XaviCanoFerrer/Educational_Five-Bar_Parallel_Robot/README.md

# Educational_Five-Bar_Parallel_Robot
Designed to play with robotics concepts such as Inverse Kinematics and control algorithms.

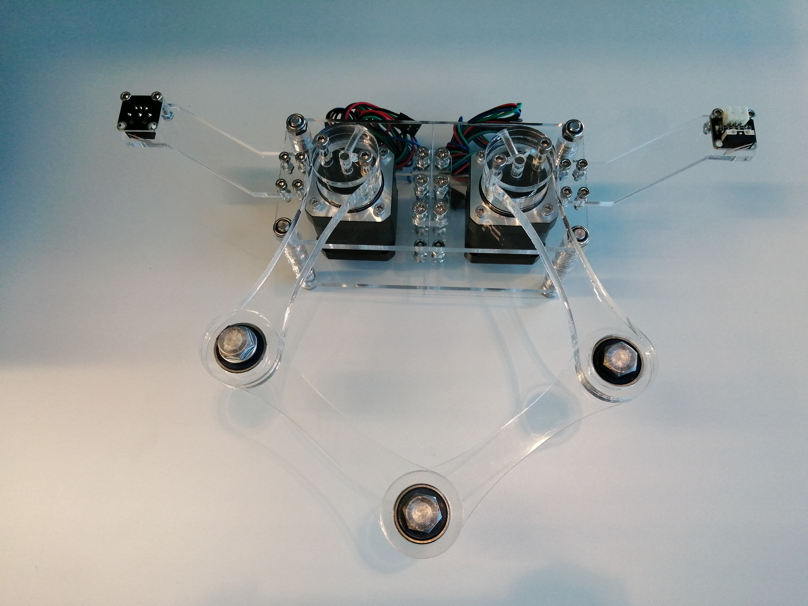
[picture p1: V2.jpg]
