XaviCanoFerrer/Educational_Five-Bar_Parallel_Robot/Educational Five-bar parallel robot_.pdf

# Educational Five-Bar Parallel Robot

Xavier Cano-Ferrer

Abstract- The present paper describes the design of an educational five-bar parallel robot based on the Teensy microcontroller. The small size of the robot and the simplicity of its components makes it suitable for its easy reproduction and programming.

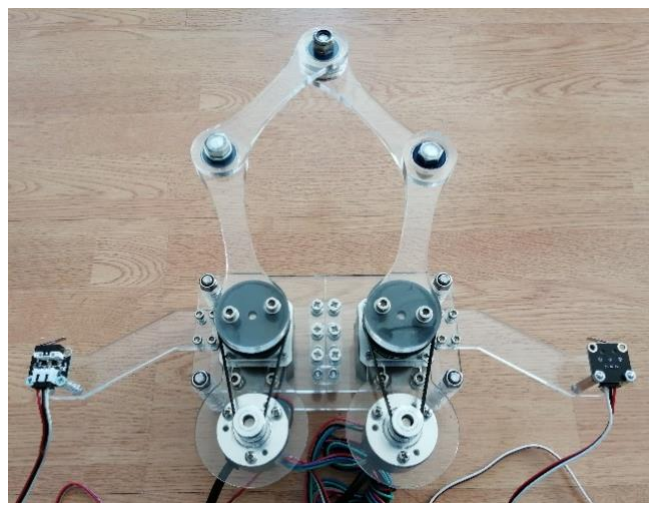
[picture p2: figure]

I. INTRODUCTION

Fiver-bar parallel robots have been studied in academia for years. Some of their most common applications are: drawing [1] [2] or engraving and manipulation [3] [4]. The presented desktop sized five-bar parallel robot (Figure 1) can be fully laser cut, manufactured in one day and programmed using the Arduino IDE and Teensyduino. For these reasons, it can be a good model to learn robotics concepts. The Robot actuators are two stepper motors Nema 17. The motors are driven by two A4988 Stepper Motor Driver Carrier, Black Edition [5]. A Teensy 3.2 microcontroller [6] is the programmable “brain” of the robot. Two limit switches [7] are located on the limits of the workspace of the robot and are used to perform the homing sequence of the robot. A PCB has been designed to operate the robot. All the dxf., step., stl. and Gerber files can be download from the Hackaday project’s page. The project started with a preliminary design based on two Pololu 37D 50:1 geared brushed DC motors sharing their shafts with two rotary incremental encoders. In this first design, the encoders were used to implement a PID position controller for each actuated joint. The control algorithm was programmed on an Arduino Mega 2650 and the motors were driven by the Pololu Dual MC33926 Motor Driver Arduino Shield. On the second design, the brushed DC motors were replaced by stepper motors and the third design is a hybrid of both. The robot is still designed to be operated with the teensyStep library but it has the incremental encoders coupled with the motor shafts to be able to record desired trajectories. All the information of the three designs can be found on the Hackaday project page [8]. In this article the third design will be treated.

II. FORWARD KINEMATICS

The forward kinematic equations have been adapted from Vathan et al. [9]. The equations can be used on the program of the robot to evaluate the position of the end effector of the robot for the given angles q1 and q2 (Figure 2).

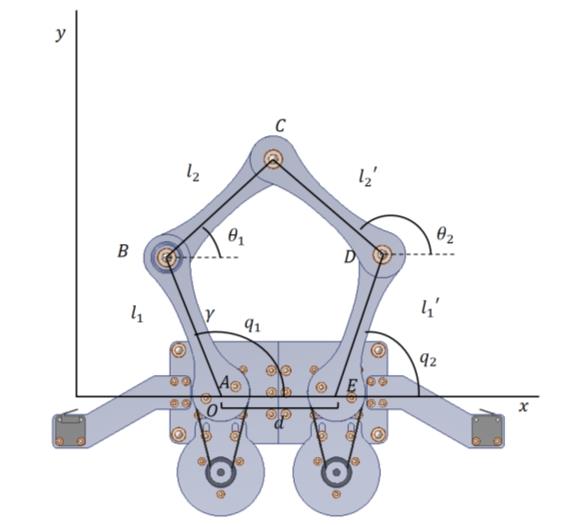
[picture p3: figure]

Figure 2: Forward kinematics diagram of the robot.

Figure 1: Five-bar parallel desktop robot manufactured and asembled.

The position of the end effector can be calculated using the equations:

xC = l1 cos q1 + l2 cos θ1 = d + l1

′
cos q2 + l2

′
cos θ2

yC = l1 sin q1 + l2 sin θ1 = l1

′
sin q2 + l2

′
sin θ2

The joints B and D are not actuated by the stepper motors. For that reason the angles θ1 and θ2 are dependant and q1 and q2 are independent:

θ1 = sin⁻¹ (
l2

′
sin θ2 += l1

′
sin q2 − l1 sin q1
l2

)

θ2 = 2 tan⁻¹ (

A ± √A² + B² − C
2
B − C

)

The value of A, B and C is found using the expressions:

A = 2l2

′
l1

′
sin q2 − 2l1l2

′
cos q1

B = 2l2

′
d − 2l1l2

′
cos q1 + 2l2

′
l1

′
cos q2

C = l1

2 − l2

2 + l1

′2
+ l2

′2
+ d

2
− l1l1

′
sin q1 sin q2
− 2l1d cos q1 + 2l1

′
d cos q2
− 2l1l1

′
cos q1 cos q2

III. INVERSE KINEMATICS

The inverse kinematics equations return the values of the angles q1 and q2 for each value [x,y] of the workspace of the robot (Figure 3). These two equations have been obtained using
geometric | methods. | The | robot | essential
dimensions to calculate the inverse kinematics can be summarized on figure 3. The inverse kinematics have been adapted from the RepRap blog of parallel SCARA 3D printer build [10] and on Shen et al. conference paper [11].

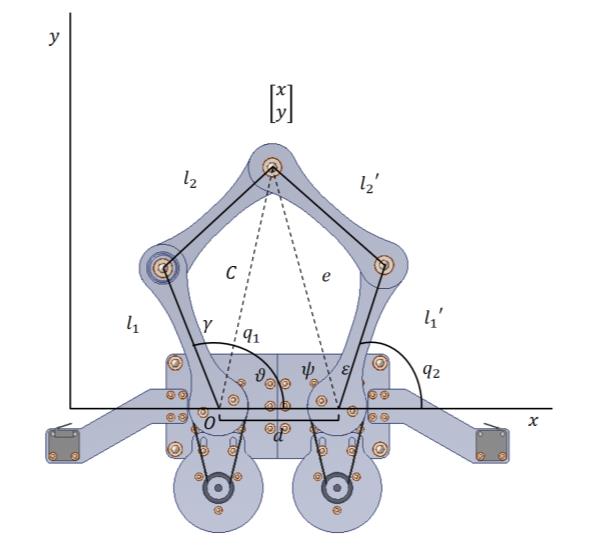
[picture p4: figure]

Figure 3: Inverse kinematics diagram of the robot.

l1 = l2 = l1

′ = l2

′ = 100 mm

d = 80 mm

Left side

C = √x
2 + y

2

θ = tan⁻¹ (

y
x

)

q1 = θ + γ

Applying the cosine rule:

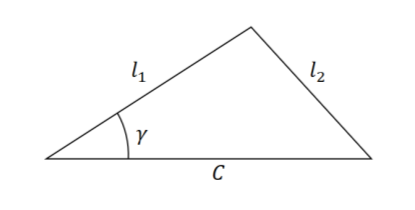
[picture p5: figure]

l2

2 = l1

2 + C
2 − 2l1C cos(γ)

γ = cos⁻¹ (
−l2

2 + l1

2 + C
2
2l1C

)

q1 = tan⁻¹ (

y
x

) + cos⁻¹ (
−l2

2 + l1

2 + C
2
2l1√x
2 + y

2

)

Right side

e = √(d − x)
2 + y

2

ψ = tan⁻¹ (

y
d − x

)

q2 = π − ε − ψ

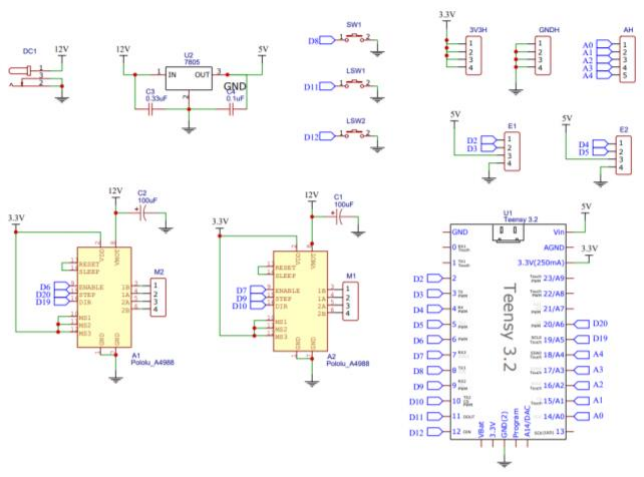
[picture p6: figure]

Applying the cosine rule again:

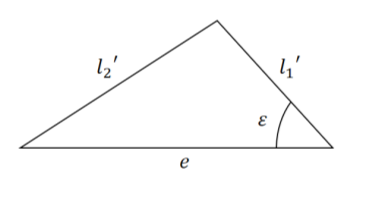
[picture p7: figure]

l2

′2
= l1

′2
+ e

2 − 2l1

′
e cos(ε)

ε = cos⁻¹ (
−l2

′2
+ l1

′2
+ e

2
2l1

′
e

)

q2 = π − tan⁻¹ (

y
d − x

) − cos⁻¹ (
−l2

′2
+ l1

′2
+ e

2

2l1

′√(d − x)
2 + y

2

)

The workspace of the robot can be configured using different modes. This has been studied and implemented on the DexTAR Robot [4] and Tien Dung et al. [12]. These modes are summarized as follows:

- Mode “+-”: q1 = θ + γ and q2 = π − ψ − ε
- Mode “-+”: q1 = θ − γ and q2 = π − ψ + ε
- Mode “--”: q1 = θ − γ and q2 = π − ψ − ε
- Mode “++”: q1 = θ + γ and q2 = π − ψ + ε

The robot program works with mode “+-” by default but this can be changed on the inverse kinematic functions in order to get the desired behaviour.

IV. ELECTRONICS

The two drivers have the three mode pins (M0, M1 and M2) pulled-up (connected to the Teensy 3.3V pin) so the robot works by default with the 3200 steps per revolution resolution. Two 100 µF capacitors are connected to the VMOT pins in order to protect the driver from spikes. The working voltage of the encoders is supplied by a LM7805 voltage regulator (Figure 4). The intention of the third switch is to have an input to tell the robot when you want to use the encoders to record a trajectory to reproduce it afterwards.

V. TIMING BELT DESIGN

The number of teeth zp of the big and the small pulley have been adjusted to get a gear ratio of 3:1 where the number of pulses per revolution of the encoder is increased in a factor of three. In the case of the selected encoders, from 600 pulses/revolution to 1800 pulses per revolution. Due to the dimensions of the robot, the adequate size of the timing belt is the GT2. Therefore, the pitch is 2.032 mm.

dp =

p zp
π

Once the big and small pulley diameters defined (D and d) the distance between both C has been calculated in order to get the desired commercial length L:

L = 2C +

π
2

(D + d) +

(D − d)

2
4C

The length obtained is 192.95 mm and a commercial and suitable option is the: RS PRO, Timing Belt, 95 Teeth, 193.04 mm length and 6mm Width [13]. The encoders can be added as an additional feature because the encoder holder can be attached to the motor holder using two M4 screws. The belt tension can be adjusted by translating the encoder holder before tightening the screws.

Figure 4: Proposed schematic of the Robot including the two stepper motors, two limit switches, Pololu A4988, two encoder connections, one switch and the Teensy 3.2.

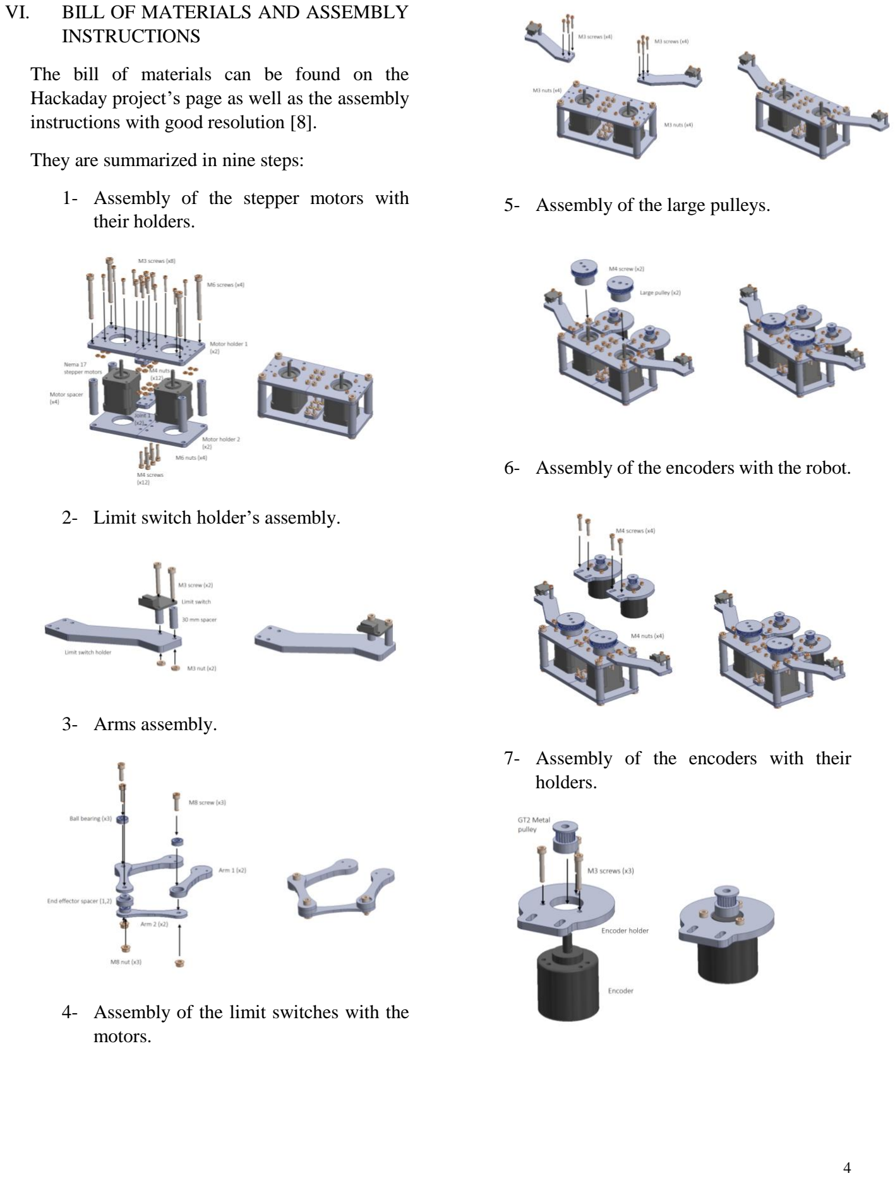
[picture p8: page 4]

VI. | BILL OF MATERIALS AND ASSEMBLY INSTRUCTIONS
| The bill of materials can be found on the Hackaday project’s page as well as the assembly instructions with good resolution [8].
| They are summarized in nine steps:
| 1- Assembly of the stepper motors with their holders.

2- Limit switch holder’s assembly.

3- Arms assembly.

4- Assembly of the limit switches with the motors.

5- Assembly of the large pulleys.

6- Assembly of the encoders with the robot.

7- Assembly of the encoders with their holders.

8- Timing belts assembly.

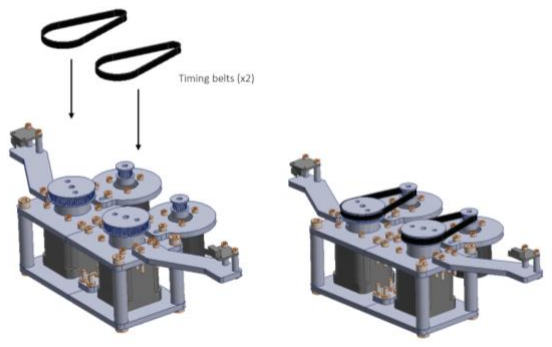
[picture p9: figure]

9- Assembly of the arms with the rest of the robot.

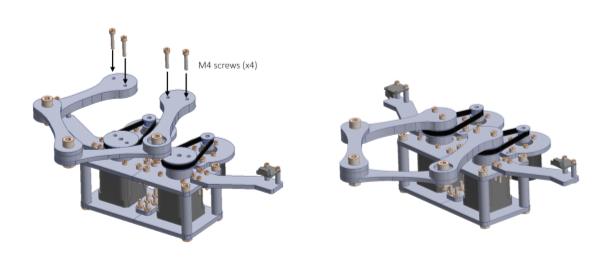
[picture p10: figure]

VI. BASIC PROGRAM

The robot is intended to use the TeensyStep library [14]. Which is perfect to manage several motors making a synchronous movement and also work with a huge range of speeds and accelerations (up to 300,000 steps/s and 500,000 steps/s^2) to get precise and fast movements to the robot. The homing procedure starts moving both arms to the right side until the right arm reaches the right end switch. Then the robot starts rotating both arms counter clock wise and counting the number of steps that the right arm is doing. When the left arm reaches the left end switch, both motors stop, the number of steps is converted to an angle and the left arm angle is set to 180 degrees. After the homing procedure, the end effector is moved on the position [40,170] and from that position is called to draw a small rectangle. A basic program of the robot drawing a square can be seen on YouTube [15].

VII. RESULTS

The Parallel robot has been designed to use the 3200 steps per revolution configuration. With this configuration, the theoretical resolution is 0.1125 degrees per step. The repeatability test has been measured in the x and y axes (N = 18, ω = 56.25 ° ∙ s

−1
and α = 112.5 ° ∙ s

−2
) using a
KATSU | Dial | Test | Indicator | [16]. | The
repeatability (RP) has been calculated using the equations proposed by Barrientos et al. where Lm and Ls are the average and the standard deviation of all the distances reached from the barycentre (Lj) [17]:

Lj = √(xj − xm)
| | | 2 + (yj − ym) | 2

Lm =

∑ Lj
n − 1

Ls = √
∑(Lj − Lm)
n − 1

RP = Lm + 3Ls

The repeatability (RP) obtained with the experimental results has been 0.1147 mm. This value corresponds to the cyan circle diameter (Figure 6).

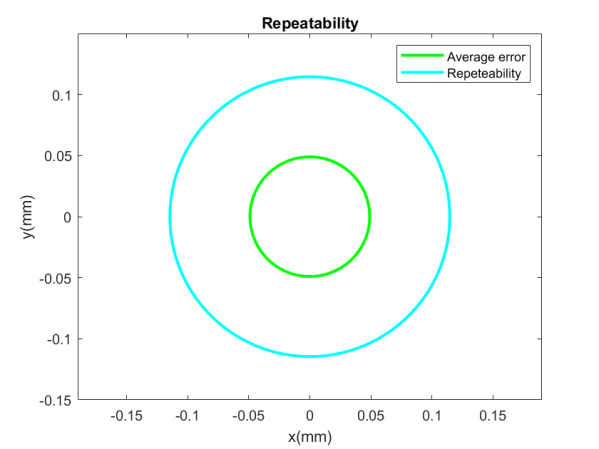
[picture p11: figure]

Figure 6: Repeatability and average error plot.

The repeatability test for the y axis can be seen on the YouTube channel [18].

VIII. DISCUSSION

This robot can be easily manufactured and assembled in a few hours. All the components are accessible and inexpensive.

The basic robot tools can be subject of study with this robot are: forward and inverse kinematics, homing sequence, stepper motor speed and acceleration profiles, closed loop position control algorithms (P, PI, PD, PID) and trajectory recording. For all this reasons this tool can be suitable to use in educational workshops for adults or practical lessons in engineering schools.

REFERENCES

[1] “https://www.thingiverse.com/thing:2480 09,” [Online].
[2] F. Cemal and I. Katip, “Real time controlled two dof five bar robot manipulator,” in Proceedings of the International Symposium of Mechanism and Machine Science, Baku, 2017.
[3] N. Siltala, A. Vuola, R. Heikkilä and R. Tuokko, “A H-scara mini robot - a dual parallel kinematics mini manipulator,” in Proceedings of the joint conference of the 41st International Symposium on Robotics, Munich, 2010.
[4] L. Campos, F. Bourbonnais, I. A. Bonev and P. Bigras , “DEVELOPMENT OF A FIVE-BAR PARALLEL ROBOT WITH LARGE WORKSPACE,” in Proceedings of the ASME 2010 International Design Engineering Technical Conferences & Computers and Information in Engineering Conference, Montreal, 2010.
[5] “https://www.pololu.com/product/2128,” [Online].
[6] “https://www.pjrc.com/store/teensy32.ht ml,” [Online].
[7] “https://www.amazon.co.uk/gp/product/B07F342J8K/ref=ppx_yo_dt_b_asin_title_o03_s00?ie=UTF8&psc=1,” [Online].
[8] “https://hackaday.io/project/173325-educational-five-bar-parallel-robot-double-scara,” [Online].
[9] L. Vathan.B, H. Kumar and B. . I. John. H, “Kinematic Analysis of Five-Bar Mechanism in Industrial Robotics”.
[10] “https://reprap.org/forum/read.php?185,4 90216,,” [Online].
[11] S. Yanli, L. Yanli, W. Hongtao, H. Chunlong and W. Shuai , “Forward and Inverse Kinematics for a Novel Double Scara Robot,” in 2nd International Symposium on Resource Exploration and Environmental Science, 2018.
[12] L. Tien Dung, K. Hee-Jun and D. Quang Vinh , “A Method for Optimal Kinematic Design of Five-bar Planar Parallel Manipulators,” 2017.
[13] “https://uk.rs-online.com/web/p/timing-belts/7785054/,” [Online].
[14] “https://luni64.github.io/TeensyStep/,” [Online].
[15] “https://www.youtube.com/watch?v=c6j G3WN4W8Y,” [Online].
[16] “https://www.amazon.co.uk/KATSU-Indicator-0-10mm-Magnetic-Storage/dp/B088FX6P91,” [Online].
[17] A. Barrientos, L. F. Peñin, C. Balaguer and R. Aracil Santoja, Fundamentos de Robótica, Madrid: McGraw-Hill, 2007.
[18] “https://www.youtube.com/watch?v=BfiHG13mHDs&feature=youtu.be,” [Online].
