XaviCanoFerrer/Educational_Five-Bar_Parallel_Robot/V1 and V2.jpg

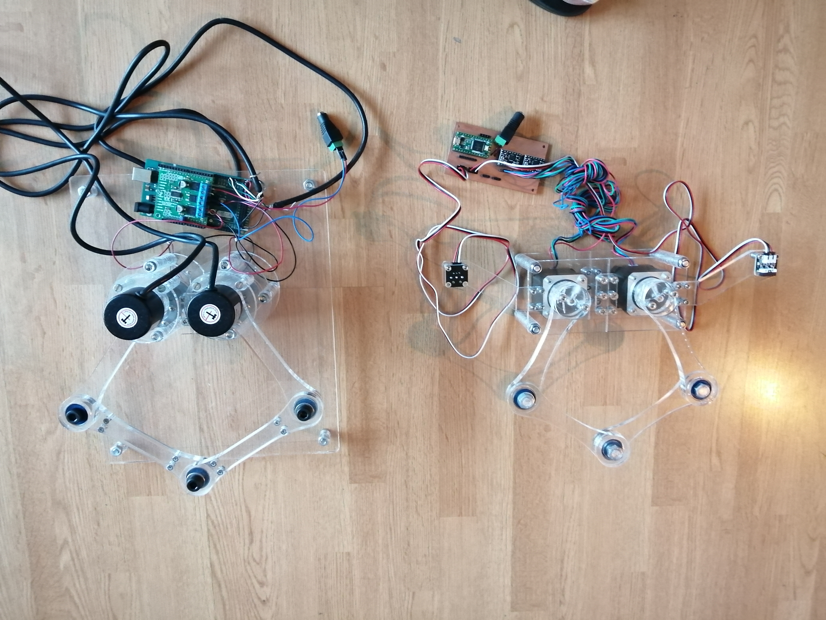
V1 and V2.jpg
