XaviCanoFerrer/Educational_Five-Bar_Parallel_Robot/V3.jpg

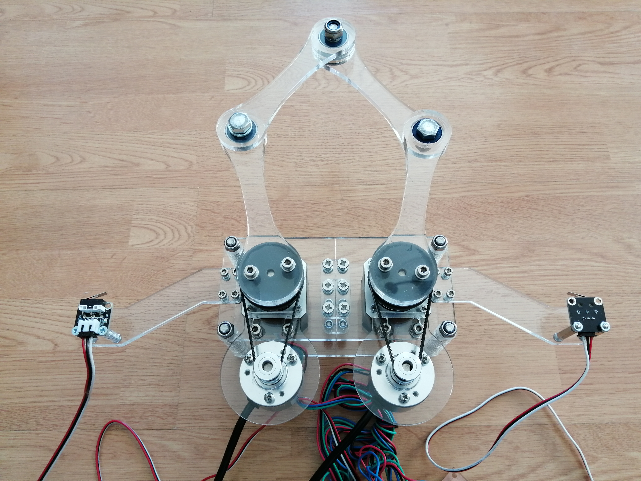
V3.jpg
