XaviCanoFerrer/Educational_Five-Bar_Parallel_Robot/Educational Five-Bar parallel robot V3/BOM.pdf

Component | Quantity Source
Nema 17 stepper motor | 2 https://www.amazon.co.uk/gp/product/B077YMHH8P/ref=ppx_yo_dt_b_asin_title_o06_s00?ie=UTF8&psc=1
Limit switches | 2 https://www.amazon.co.uk/gp/product/B07F342J8K/ref=ppx_yo_dt_b_asin_title_o04_s00?ie=UTF8&psc=1
A4988 Stepper Motor Driver | 2 https://www.pololu.com/product/2128
Teensy 3.2 | 1 https://www.pjrc.com/store/teensy32.html
PCB | 1 Gerber files
Large pulley | 2 STEP/STL
Arm 1 | 2 STEP/STL/DXF
Arm 2 | 2 STEP/STL/DXF
Arm spacer 1 | 2 STEP/STL/DXF
Arm cover | 2 STEP/STL/DXF
Motor spacer | 4 STEP/STL/DXF
Motor holder 1 | 2 STEP/STL/DXF
Motor holder 2 | 2 STEP/STL/DXF
Joint 1 | 2 STEP/STL/DXF
Limit switch holder | 2 STEP/STL/DXF
Limit switch spacer | 6 STEP/STL/DXF
End effector spacer | 1 STEP/STL/DXF
End effector spacer 2 | 1 STEP/STL/DXF
M6 screws | 4
M6 nuts | 4
M4 screws | 16
M4 nuts | 12
M4 brass threaded inserts | 4
M3 screws | 20
M3 nuts | 12
M8 screws | 3
M8 nuts | 3
M8 washers | 2
Skateboard Bearings | 3
Timing belt | 2 https://uk.rs-online.com/web/p/timing-belts/7785054/

Small pulley

2

https://www.amazon.com/RuiLing-Aluminum-Synchronous-Printer-Accessories/dp/B07PPGQV6K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 TJBNzdOU1dVVjBYJmVuY3J5cHRlZEFkSWQ9QTA5OTUxNTJISUVEVzlSNEQxSjcmd2lkZ2V0TmFtZT1zcF9hdGYmYWN0a W9uPWNsaWNrUmVkaXJlY3QmZG9Ob3RMb2dDbGljaz10cnVl
