XaviCanoFerrer/Educational_Five-Bar_Parallel_Robot/Educational Five-Bar parallel robot V3/STEP files/Arm 2 .STEP

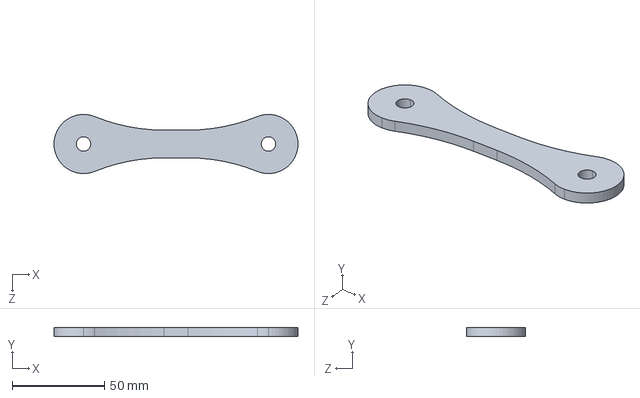
[picture p15: CAD file, 2021-07-24]
Educational Five-Bar parallel robot V3/STEP files/Arm 2 .STEP
132.0 x 5.00 x 32.0 mm
