XaviCanoFerrer/Educational_Five-Bar_Parallel_Robot/Educational Fiver-Bar Parallel robot V2/Dxf and Ai files/Arm Cover.DXF

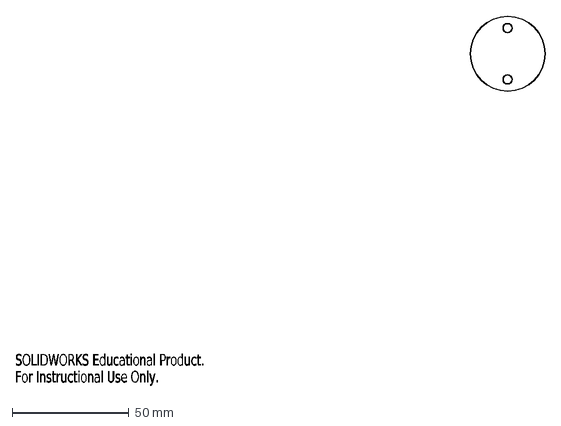
[picture p16: CAD file, 2021-07-24]
Educational Fiver-Bar Parallel robot V2/Dxf and Ai files/Arm Cover.DXF
SOLIDWORKS Educational Product.
For Instructional Use Only.
