XaviCanoFerrer/Educational_Five-Bar_Parallel_Robot/Educational Fiver-Bar Parallel robot V2/Step files/Arm Cover.STEP

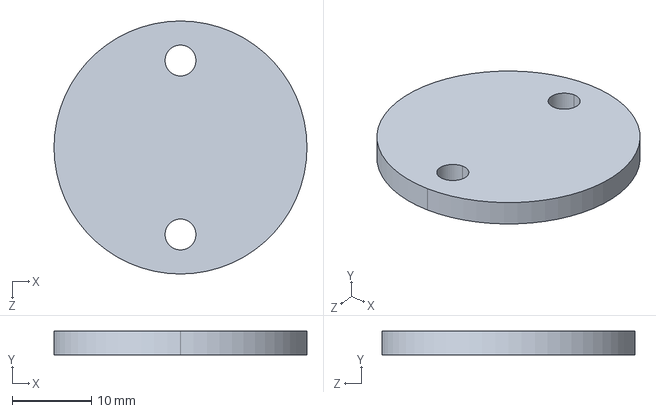
[picture p17: CAD file, 2021-07-24]
Educational Fiver-Bar Parallel robot V2/Step files/Arm Cover.STEP
32.0 x 3.00 x 32.0 mm
