XaviCanoFerrer/Educational_Five-Bar_Parallel_Robot/Educational Five-Bar parallel robot V3/STEP files/End effector spacer 2.STEP

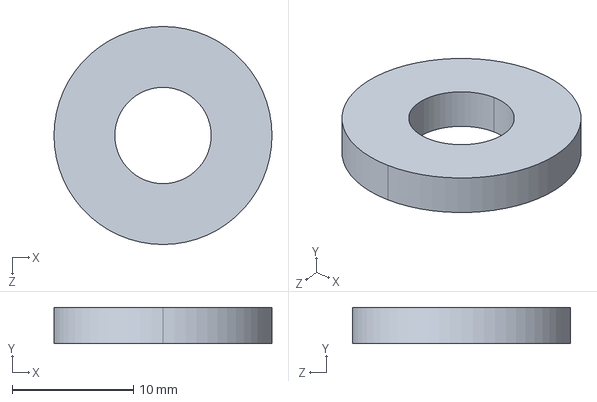
[picture p18: CAD file, 2021-07-24]
Educational Five-Bar parallel robot V3/STEP files/End effector spacer 2.STEP
18.0 x 3.00 x 18.0 mm
