XaviCanoFerrer/Educational_Five-Bar_Parallel_Robot/Educational Fiver-Bar Parallel robot V2/Dxf and Ai files/Arm 2 .DXF

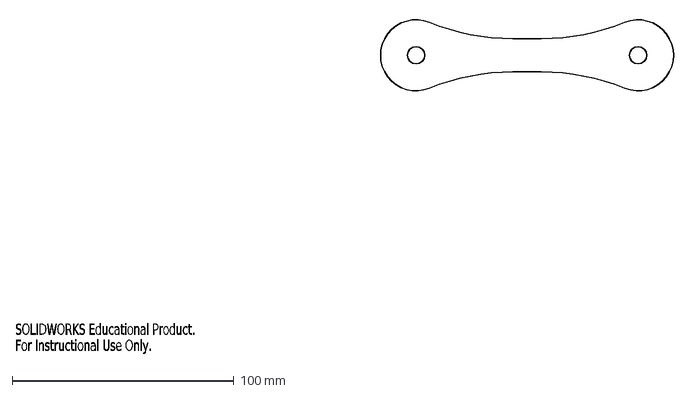
[picture p19: CAD file, 2021-07-24]
Educational Fiver-Bar Parallel robot V2/Dxf and Ai files/Arm 2 .DXF
SOLIDWORKS Educational Product.
For Instructional Use Only.
