XaviCanoFerrer/Educational_Five-Bar_Parallel_Robot/Educational Fiver-Bar Parallel robot V2/Step files/Limit Switch.STEP

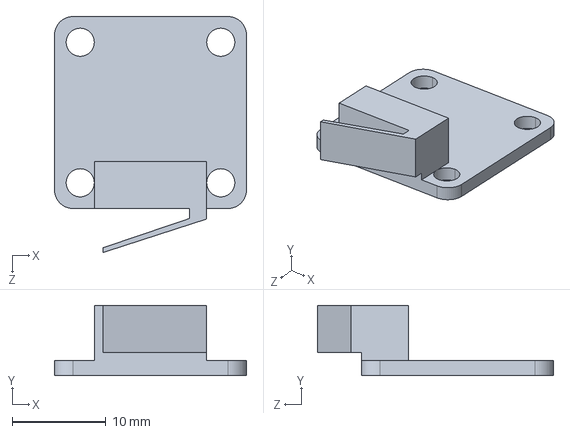
[picture p20: CAD file, 2021-07-24]
Educational Fiver-Bar Parallel robot V2/Step files/Limit Switch.STEP
20.5 x 7.48 x 25.2 mm
