XaviCanoFerrer/Educational_Five-Bar_Parallel_Robot/Educational Five-Bar parallel robot V3/STEP files/Spacer.STEP

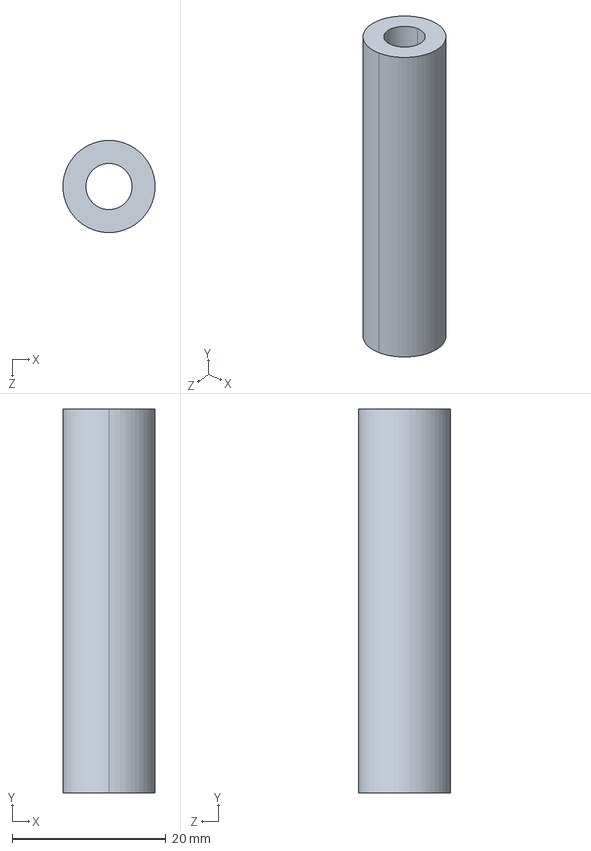
[picture p21: CAD file, 2021-07-24]
Educational Five-Bar parallel robot V3/STEP files/Spacer.STEP
12.0 x 50.0 x 12.0 mm
