XaviCanoFerrer/Educational_Five-Bar_Parallel_Robot/Educational Fiver-Bar Parallel robot V2/Dxf and Ai files/End effector spacer.DXF

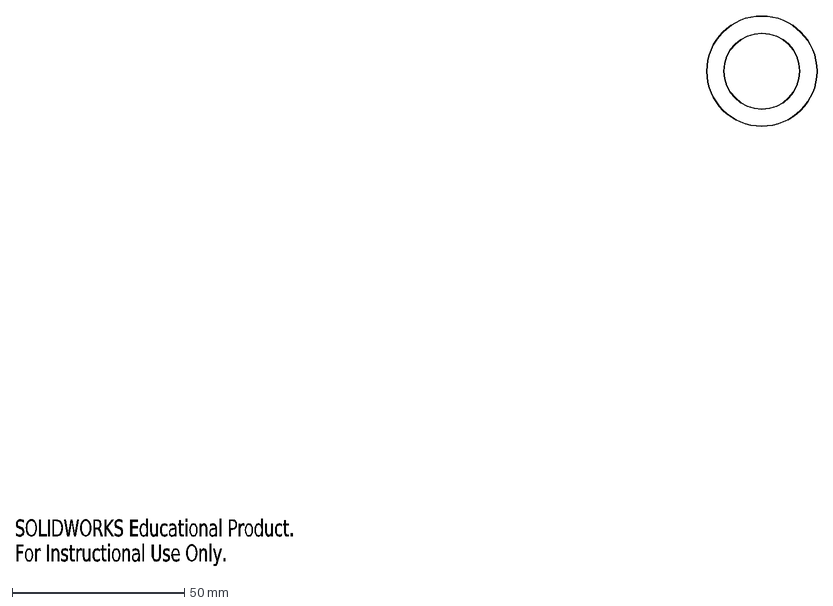
[picture p22: CAD file, 2021-07-24]
Educational Fiver-Bar Parallel robot V2/Dxf and Ai files/End effector spacer.DXF
SOLIDWORKS Educational Product.
For Instructional Use Only.
