XaviCanoFerrer/Educational_Five-Bar_Parallel_Robot/Educational Fiver-Bar Parallel robot V2/Step files/Arm spacer 1.STEP

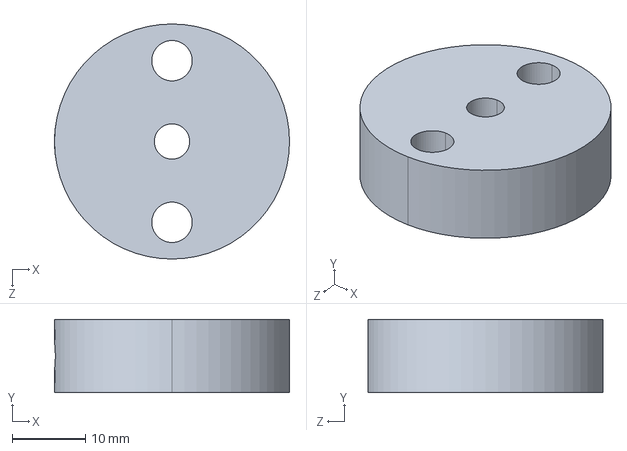
[picture p23: CAD file, 2021-07-24]
Educational Fiver-Bar Parallel robot V2/Step files/Arm spacer 1.STEP
32.0 x 10.0 x 32.0 mm
