XaviCanoFerrer/Educational_Five-Bar_Parallel_Robot/Educational Five-Bar parallel robot V3/STEP files/Limit Switch - Holder.STEP

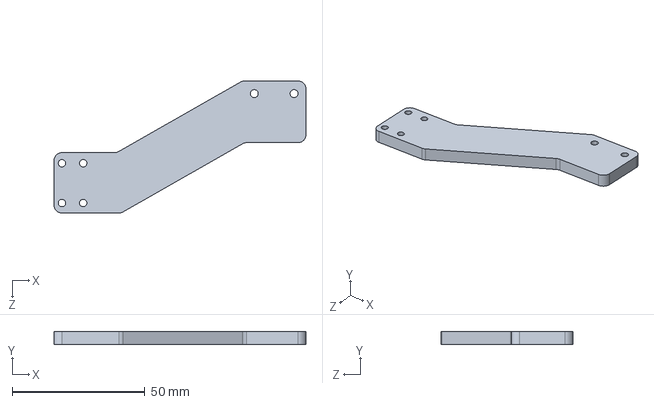
[picture p24: CAD file, 2021-07-24]
Educational Five-Bar parallel robot V3/STEP files/Limit Switch - Holder.STEP
95.0 x 5.00 x 49.8 mm
