XaviCanoFerrer/Educational_Five-Bar_Parallel_Robot/Educational Five-Bar parallel robot V3/STEP files/Modified Arm spacer pulley.stp

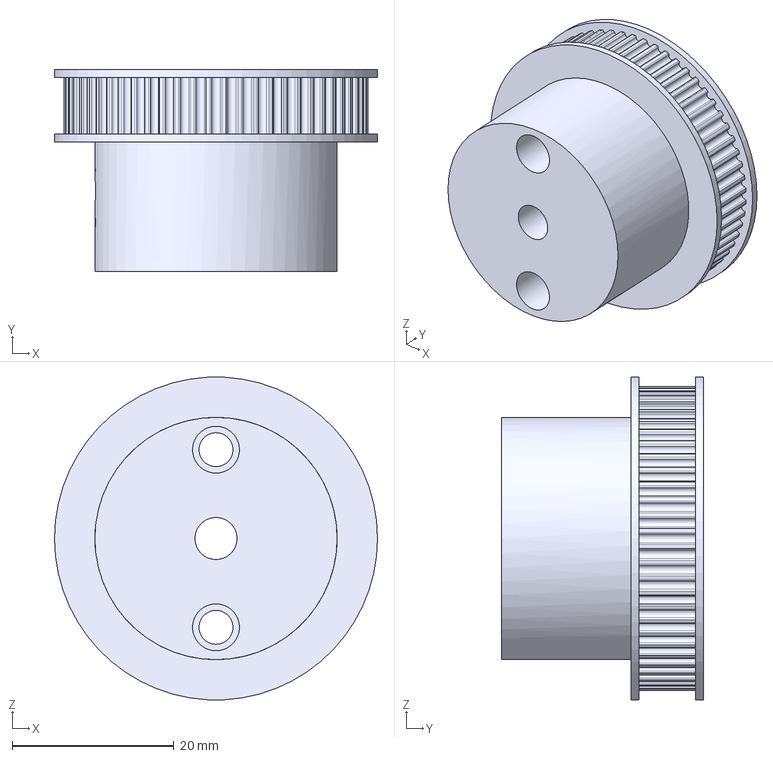
[picture p27: CAD file, 2021-07-24]
Educational Five-Bar parallel robot V3/STEP files/Modified Arm spacer pulley.stp
40.0 x 25.0 x 39.9 mm
