XaviCanoFerrer/Educational_Five-Bar_Parallel_Robot/Educational Five-Bar parallel robot V3/STEP files/Limit switch spacer.STEP

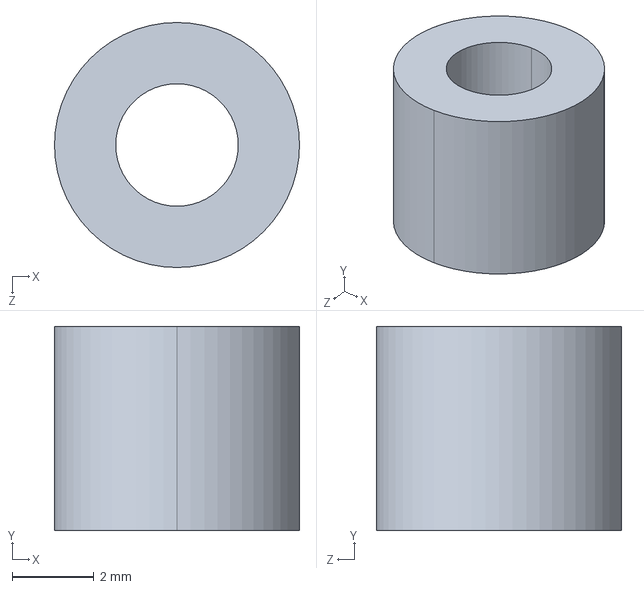
[picture p29: CAD file, 2021-07-24]
Educational Five-Bar parallel robot V3/STEP files/Limit switch spacer.STEP
6.00 x 5.00 x 6.00 mm
