XaviCanoFerrer/Educational_Five-Bar_Parallel_Robot/Educational Five-Bar parallel robot V3/STEP files/End effector spacer.STEP

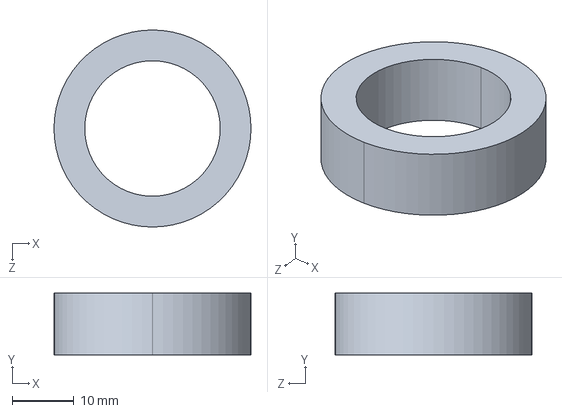
[picture p31: CAD file, 2021-07-24]
Educational Five-Bar parallel robot V3/STEP files/End effector spacer.STEP
32.0 x 10.0 x 32.0 mm
