XaviCanoFerrer/Educational_Five-Bar_Parallel_Robot/Educational Fiver-Bar Parallel robot V2/Dxf and Ai files/Arm spacer 1.DXF

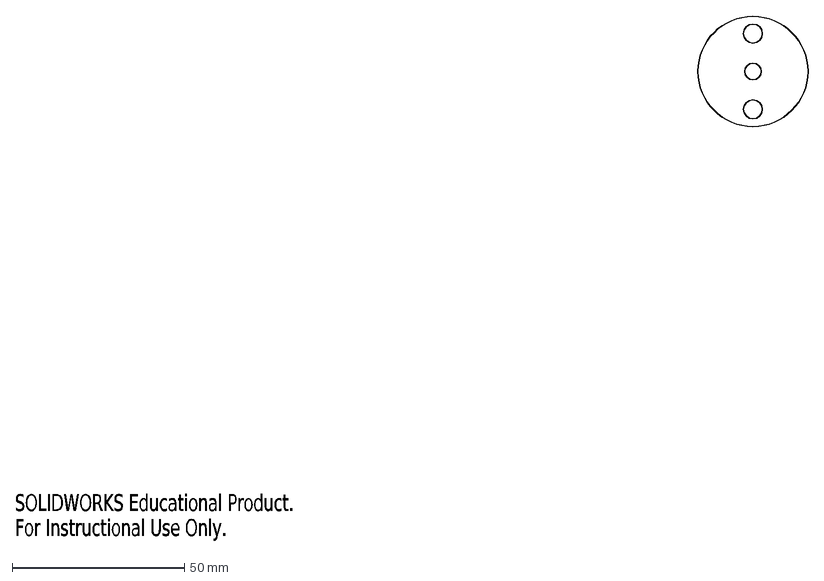
[picture p32: CAD file, 2021-07-24]
Educational Fiver-Bar Parallel robot V2/Dxf and Ai files/Arm spacer 1.DXF
SOLIDWORKS Educational Product.
For Instructional Use Only.
