XaviCanoFerrer/Educational_Five-Bar_Parallel_Robot/Educational Fiver-Bar Parallel robot V2/Step files/Nema 17.STEP

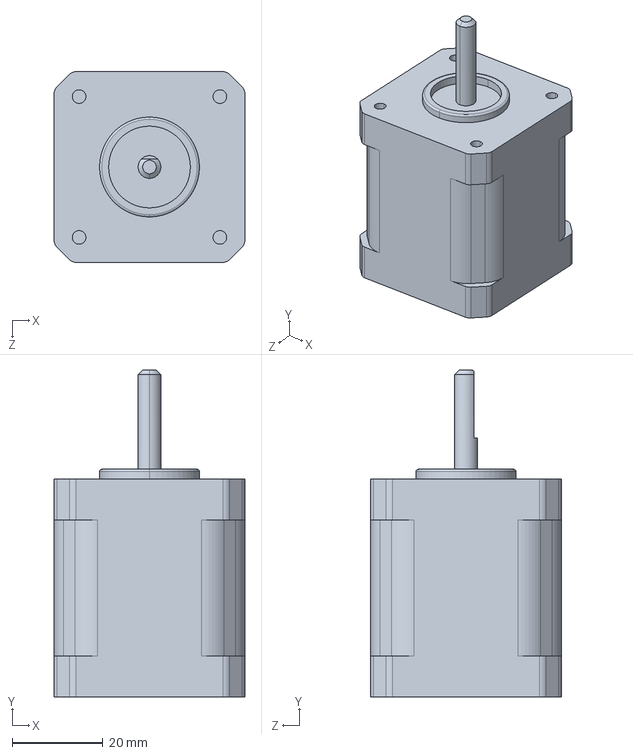
[picture p33: CAD file, 2021-07-24]
Educational Fiver-Bar Parallel robot V2/Step files/Nema 17.STEP
42.0 x 72.0 x 42.0 mm
