XaviCanoFerrer/Educational_Five-Bar_Parallel_Robot/Educational Fiver-Bar Parallel robot V2/Dxf and Ai files/Motor Holder 2.DXF

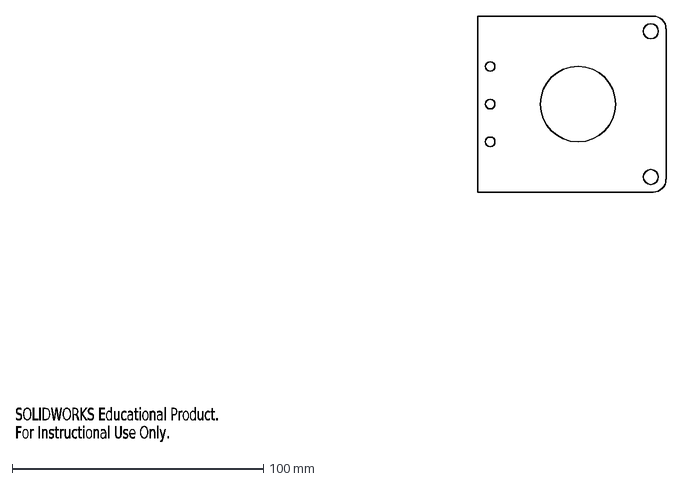
[picture p34: CAD file, 2021-07-24]
Educational Fiver-Bar Parallel robot V2/Dxf and Ai files/Motor Holder 2.DXF
SOLIDWORKS Educational Product.
For Instructional Use Only.
