XaviCanoFerrer/Educational_Five-Bar_Parallel_Robot/Educational Fiver-Bar Parallel robot V2/Step files/Joint 1.STEP

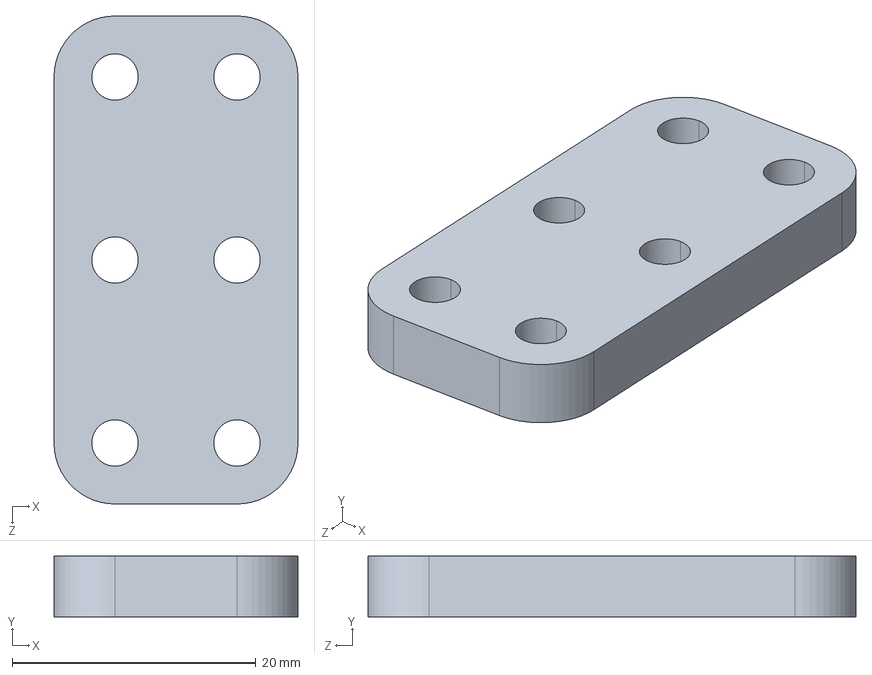
[picture p35: CAD file, 2021-07-24]
Educational Fiver-Bar Parallel robot V2/Step files/Joint 1.STEP
20.0 x 5.00 x 40.0 mm
