XaviCanoFerrer/Educational_Five-Bar_Parallel_Robot/Educational Five-Bar parallel robot V3/STEP files/Motor Holder 2.STEP

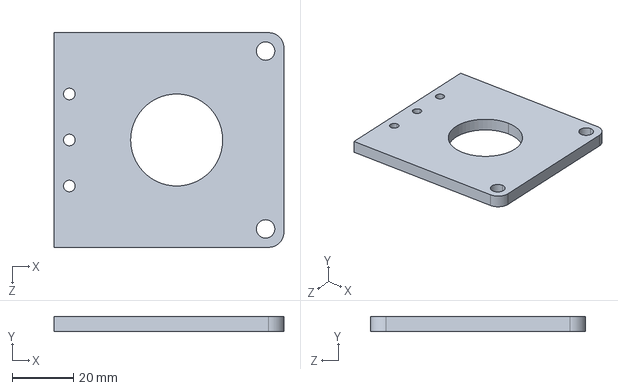
[picture p36: CAD file, 2021-07-24]
Educational Five-Bar parallel robot V3/STEP files/Motor Holder 2.STEP
75.0 x 5.00 x 70.0 mm
