XaviCanoFerrer/Educational_Five-Bar_Parallel_Robot/Educational Fiver-Bar Parallel robot V2/Dxf and Ai files/Spacer.DXF

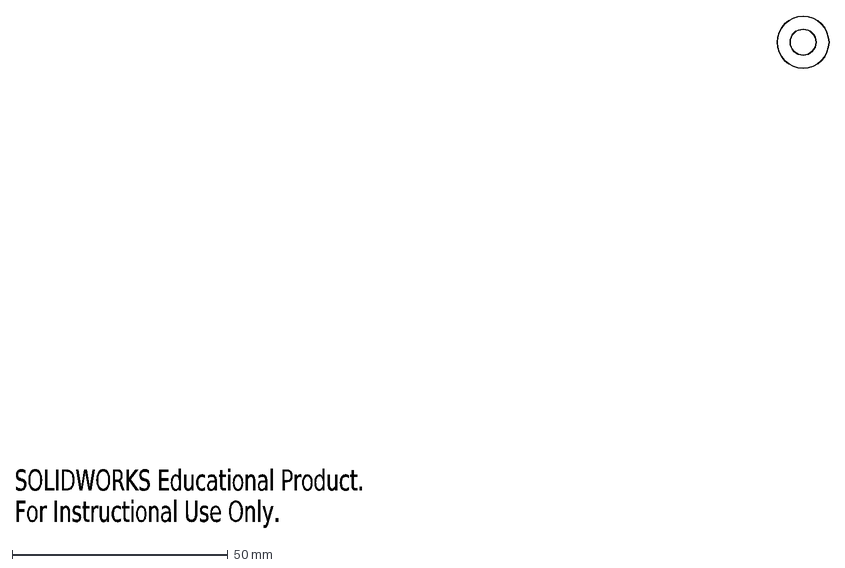
[picture p37: CAD file, 2021-07-24]
Educational Fiver-Bar Parallel robot V2/Dxf and Ai files/Spacer.DXF
SOLIDWORKS Educational Product.
For Instructional Use Only.
