XaviCanoFerrer/Educational_Five-Bar_Parallel_Robot/Educational Fiver-Bar Parallel robot V2/Dxf and Ai files/Limit Switch - Holder.DXF

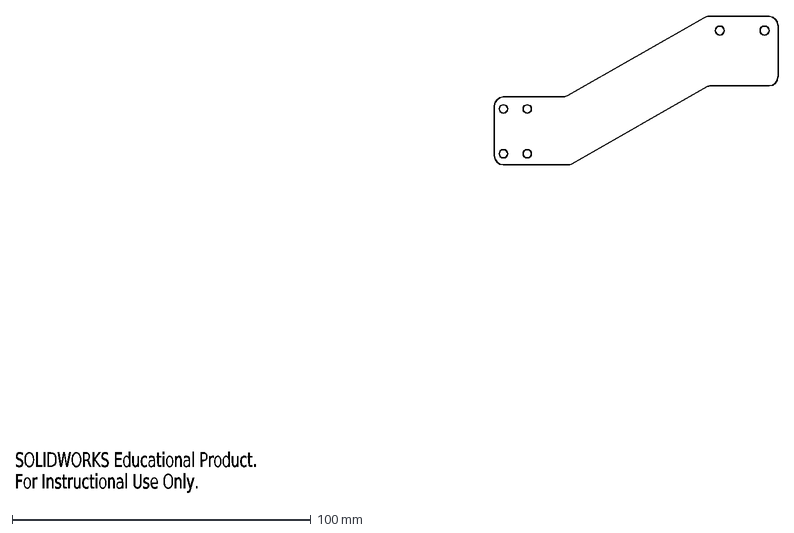
[picture p38: CAD file, 2021-07-24]
Educational Fiver-Bar Parallel robot V2/Dxf and Ai files/Limit Switch - Holder.DXF
SOLIDWORKS Educational Product.
For Instructional Use Only.
