XaviCanoFerrer/Educational_Five-Bar_Parallel_Robot/Educational Five-Bar parallel robot V3/STEP files/Encoder holder.stp

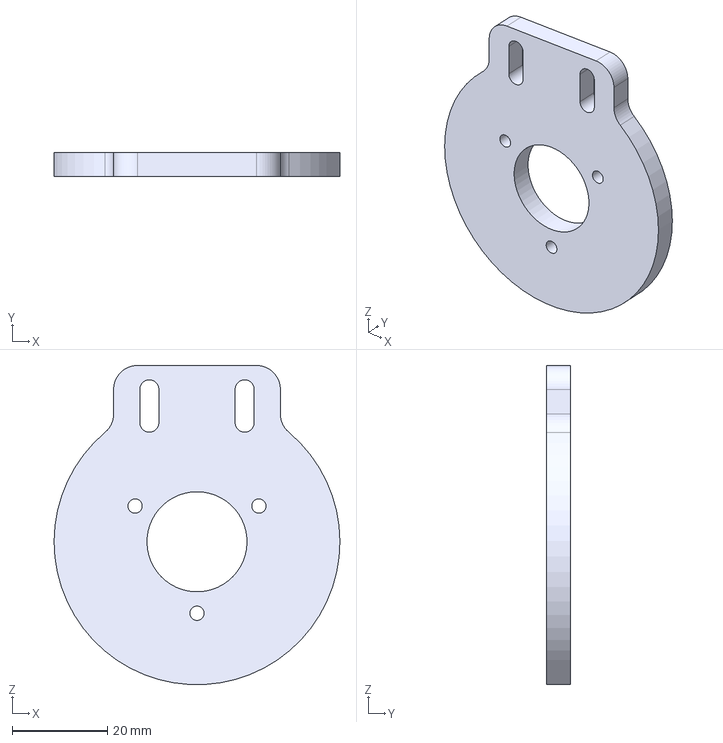
[picture p41: CAD file, 2021-07-24]
Educational Five-Bar parallel robot V3/STEP files/Encoder holder.stp
60.0 x 5.00 x 67.0 mm
