XaviCanoFerrer/Educational_Five-Bar_Parallel_Robot/Educational Five-Bar parallel robot V3/STEP files/Arm 1.stp

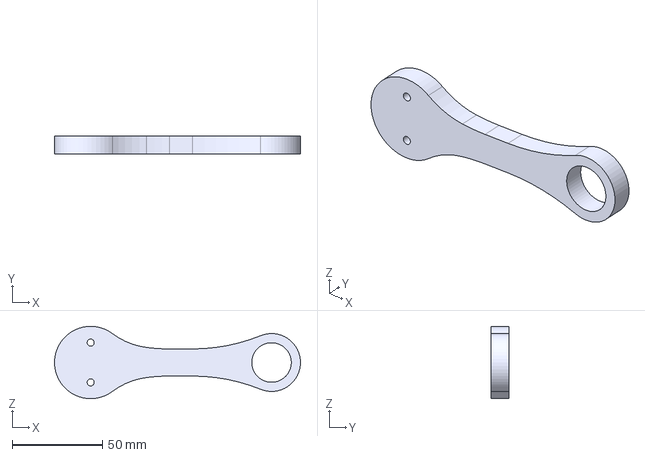
[picture p42: CAD file, 2021-07-24]
Educational Five-Bar parallel robot V3/STEP files/Arm 1.stp
136.0 x 10.0 x 40.0 mm
