XaviCanoFerrer/Educational_Five-Bar_Parallel_Robot/(list of files, cad)

Other CAD files:
Educational Fiver-Bar Parallel robot V2/Step files/Motor Holder 1.STEP
Educational Five-Bar parallel robot V3/STEP files/Motor Holder 1.stp
Educational Five-Bar Parallel robot V1/Step files/Arm 1.STEP
Educational Five-Bar Parallel robot V1/Step files/Arm 2 .STEP
Educational Five-Bar Parallel robot V1/Step files/Arm 3.STEP
Educational Five-Bar Parallel robot V1/Step files/Arm spacer 1.STEP
Educational Five-Bar Parallel robot V1/Step files/Arm spacer 2.STEP
Educational Five-Bar Parallel robot V1/Step files/Encoder holder.STEP
Educational Five-Bar Parallel robot V1/Step files/Motors holder 2.STEP
Educational Five-Bar Parallel robot V1/Step files/Motors holder Base 2.STEP
Educational Five-Bar Parallel robot V1/Step files/SCARA Base.STEP
Educational Five-Bar Parallel robot V1/Step files/Spacer 1.STEP
Educational Five-Bar Parallel robot V1/Step files/Spacer.STEP
Educational Five-Bar Parallel robot V1/dxf files/Arm 1 .DXF
Educational Five-Bar Parallel robot V1/dxf files/Arm 2 .DXF
Educational Five-Bar Parallel robot V1/dxf files/Arm 3.DXF
Educational Five-Bar Parallel robot V1/dxf files/Arm spacer 1.DXF
Educational Five-Bar Parallel robot V1/dxf files/Arm spacer 2.DXF
Educational Five-Bar Parallel robot V1/dxf files/Encoder holder.DXF
Educational Five-Bar Parallel robot V1/dxf files/Motors holder 2.DXF
Educational Five-Bar Parallel robot V1/dxf files/Motors holder Base 2.DXF
Educational Five-Bar Parallel robot V1/dxf files/SCARA Base.DXF
Educational Five-Bar Parallel robot V1/dxf files/Spacer 1.DXF
Educational Five-Bar Parallel robot V1/dxf files/Spacer.DXF
Educational Five-Bar parallel robot V3/DXF files/Arm 1.dxf
Educational Five-Bar parallel robot V3/DXF files/Encoder holder.dxf
Educational Five-Bar parallel robot V3/DXF files/Motor holder 1.dxf
Educational Five-Bar parallel robot V3/STL files/Arm 1.stl
Educational Five-Bar parallel robot V3/STL files/Arm 2 .STL
Educational Five-Bar parallel robot V3/STL files/Arm Cover.STL
Educational Five-Bar parallel robot V3/STL files/Arm spacer 1.STL
Educational Five-Bar parallel robot V3/STL files/End effector spacer 2.STL
Educational Five-Bar parallel robot V3/STL files/End effector spacer.STL
Educational Five-Bar parallel robot V3/STL files/Joint 1.STL
Educational Five-Bar parallel robot V3/STL files/Limit Switch - Holder.STL
Educational Five-Bar parallel robot V3/STL files/Limit switch spacer.STL
Educational Five-Bar parallel robot V3/STL files/Modified Arm spacer pulley.stl
Educational Five-Bar parallel robot V3/STL files/Motor Holder 1.stl
Educational Five-Bar parallel robot V3/STL files/Motor Holder 2.STL
Educational Five-Bar parallel robot V3/STL files/Spacer.STL
Educational Fiver-Bar Parallel robot V2/STL files/Arm 1.STL
Educational Fiver-Bar Parallel robot V2/STL files/Arm 2 .STL
Educational Fiver-Bar Parallel robot V2/STL files/Arm Cover.STL
Educational Fiver-Bar Parallel robot V2/STL files/Arm spacer 1.STL
Educational Fiver-Bar Parallel robot V2/STL files/End effector spacer 2.STL
Educational Fiver-Bar Parallel robot V2/STL files/End effector spacer.STL
Educational Fiver-Bar Parallel robot V2/STL files/Joint 1.STL
Educational Fiver-Bar Parallel robot V2/STL files/Limit Switch - Holder.STL
Educational Fiver-Bar Parallel robot V2/STL files/Limit switch spacer.STL
Educational Fiver-Bar Parallel robot V2/STL files/Motor Holder 1.STL
Educational Fiver-Bar Parallel robot V2/STL files/Motor Holder 2.STL
Educational Fiver-Bar Parallel robot V2/STL files/Spacer.STL
