XaviCanoFerrer/Educational_Five-Bar_Parallel_Robot/V1.jpg

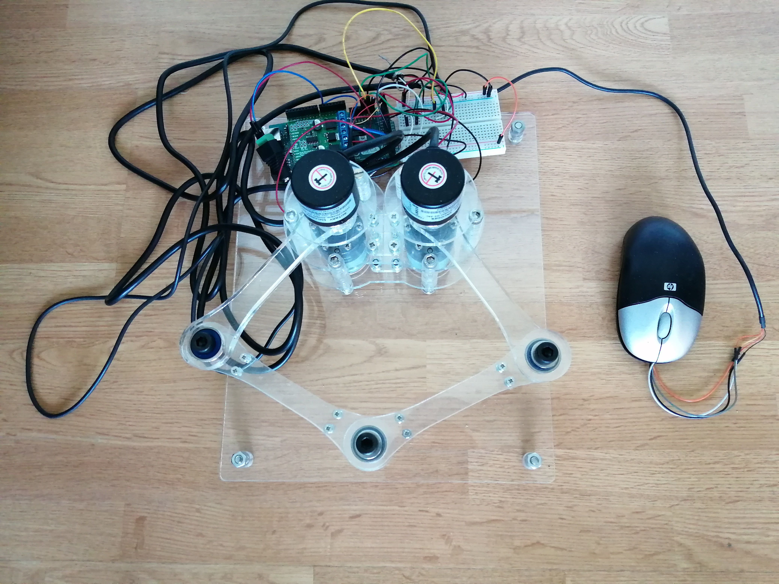
V1.jpg
